YoussefAwad91/4-Bit_ALU/(list of files, drawings)

Other design files:
ALU Design.circ
